ehadziabdic/Crossroad-Trafficlight-System/export/pictures/IMG_3037.jpg

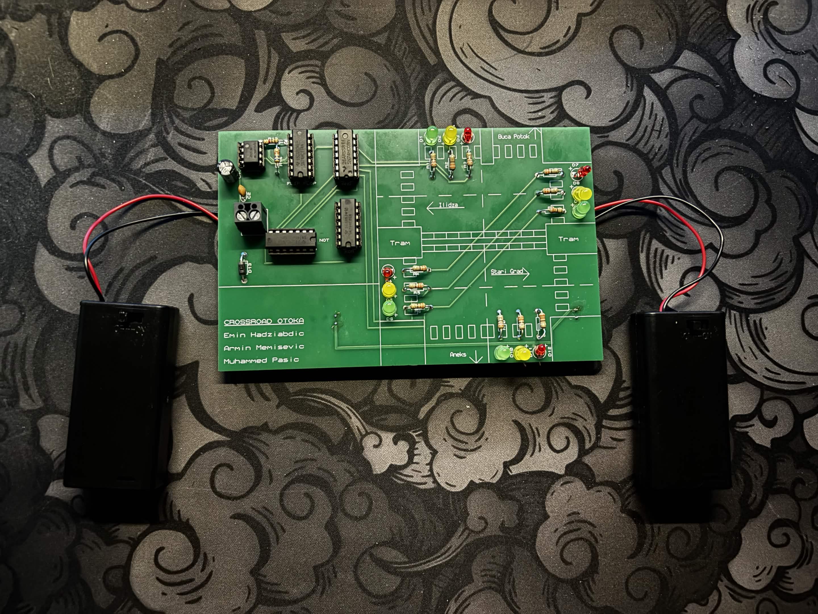
export/pictures/IMG_3037.jpg
