ehadziabdic/Crossroad-Trafficlight-System/export/pictures/IMG_3051.jpg

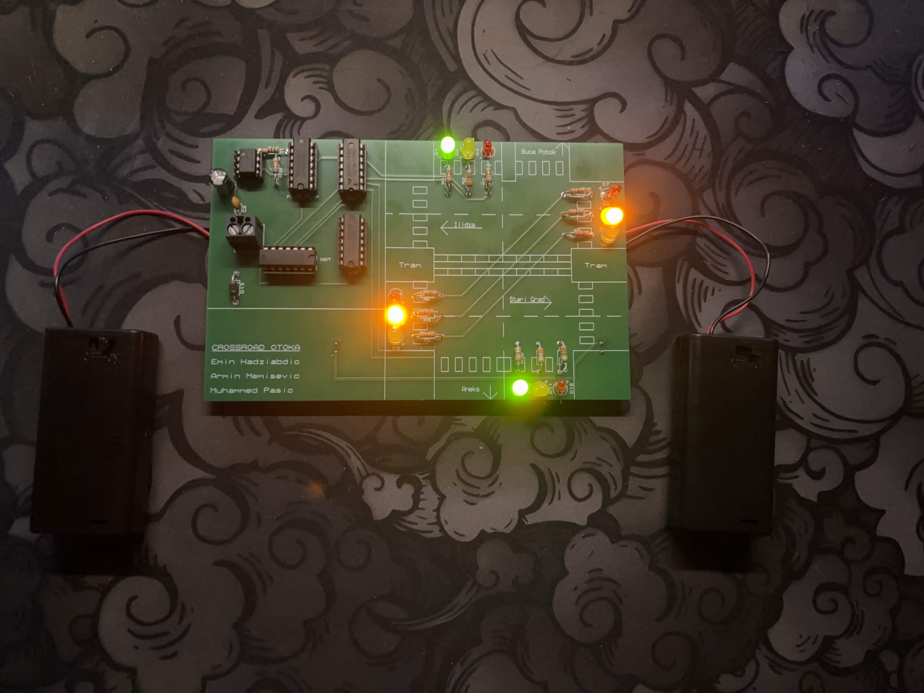
export/pictures/IMG_3051.jpg
