ehadziabdic/Crossroad-Trafficlight-System/(list of files, drawings)

Other design files:
src/Crossroad-Schematics.pdsprj
