ehadziabdic/Crossroad-Trafficlight-System/(commit log)

2026-05-28 Structure change and schematics update
    [Crossroad-Schematics.pdsprj]
2026-06-06 Added battery slots and NE555 timer to the schematics.
    [Crossroad-Schematics.pdsprj]
