ehadziabdic/Crossroad-Trafficlight-System/(notices)

Notices in the files:
README.md:
License: MIT
